ben-kuhn/Remote-LDGControl/cases/cable_clamp.stl

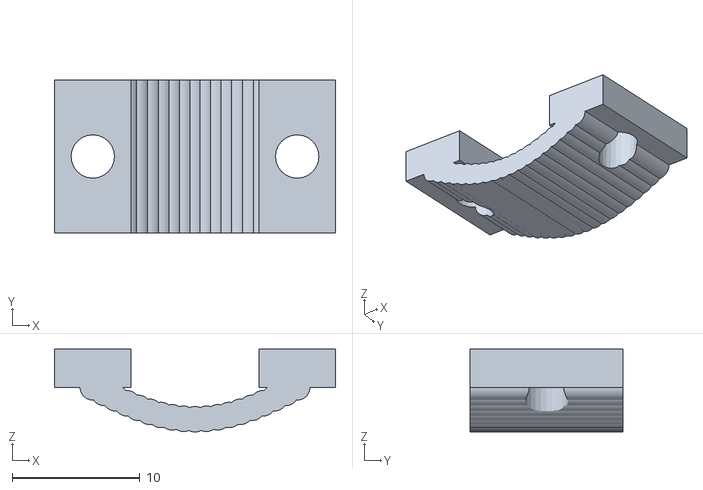
[picture p1: CAD file, 2026-11-12]
cases/cable_clamp.stl
22.0 x 12.0 x 6.50
