ben-kuhn/Remote-LDGControl/cases/remote_base.stl

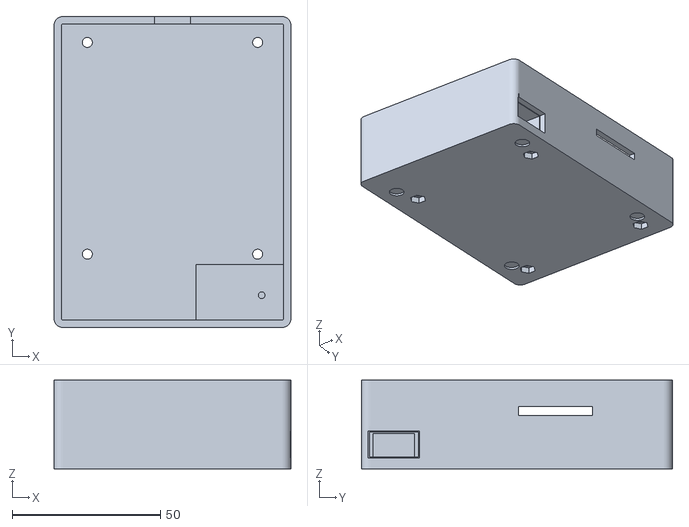
[picture p2: CAD file, 2026-11-12]
cases/remote_base.stl
80.0 x 105.0 x 30.0
