ben-kuhn/Remote-LDGControl/cases/remote_lid.stl

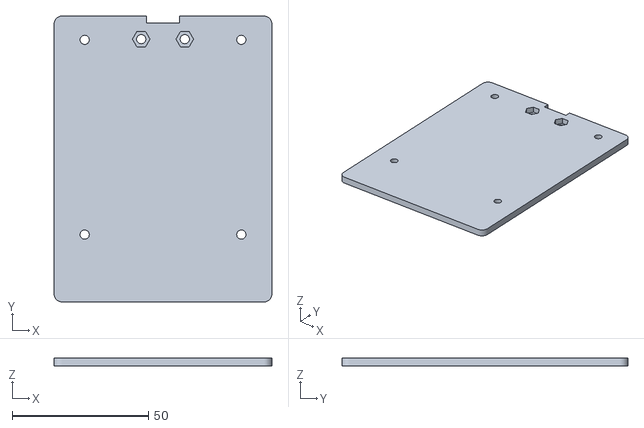
[picture p3: CAD file, 2026-11-12]
cases/remote_lid.stl
80.0 x 105.0 x 3.00
