ben-kuhn/Remote-LDGControl/src/web_server.cpp

#include "web_server.h"
#include "config_manager.h"
#include "portal_cert.h"
#include "config.h"
#include <ArduinoJson.h>
#include <LittleFS.h>
#include <WiFi.h>
#include <HTTPSServer.hpp>
#include <SSLCert.hpp>
#include <HTTPRequest.hpp>
#include <HTTPResponse.hpp>
#include <WebsocketHandler.hpp>
#include <WebsocketNode.hpp>
#include <freertos/FreeRTOS.h>
#include <vector>
#include <algorithm>

namespace hsv = httpsserver;

// ---------------------------------------------------------------------------
// Singleton + shared SSE state.
//
// The HTTPS library accepts plain function pointers for route handlers, so we
// can't capture `this` in lambdas. Handlers read from s_instance to reach
// LdgWebServer members, and from s_sse for the SSE push state. Each SSE
// subscriber runs its own connection task and polls s_sse seq counters.
// ---------------------------------------------------------------------------

static LdgWebServer* s_instance = nullptr;

struct SseState {
    portMUX_TYPE mux;
    uint32_t meterSeq;
    char meterJson[384];
    uint32_t statusSeq;
    char statusJson[96];
};
static SseState s_sse = {
    portMUX_INITIALIZER_UNLOCKED,
    0, "", 0, ""
};

// ---------------------------------------------------------------------------
// WebSocket meter subscribers.
//
// Unlike SSE, the library dispatches WS handlers non-inline — the slot stays
// in STATE_WEBSOCKET and the connection's loop() polls for client data, so a
// long-lived WS handler doesn't block the slot the way h_events does. That
// lets us keep one persistent connection per browser (no per-command TLS
// handshakes, no SSE session caps, no close-on-button-click dance) AND let
// command POSTs dispatch on free slots concurrently.
//
// Registry lives in the webServer task only — both registration (handler
// ctor) and broadcast (LdgWebServer::loop) execute there sequentially, so we
// don't need a mutex around the vector. The handler's dtor unregisters
// itself; the library calls delete on the handler from STATE_WEBSOCKET when
// the client closes (or the connection errors), and that happens between
// HTTPServer::loop() iterations, never concurrently with broadcastMeter().
// ---------------------------------------------------------------------------
class MeterWebsocketHandler : public hsv::WebsocketHandler {
public:
    MeterWebsocketHandler() { s_subs.push_back(this); }
    ~MeterWebsocketHandler() override {
        s_subs.erase(std::remove(s_subs.begin(), s_subs.end(), this), s_subs.end());
    }

    // Client → server messages are ignored for now; commands still use the
    // existing POST /api/command/* endpoints.
    void onMessage(hsv::WebsocketInputStreambuf* buf) override { (void)buf; }
    void onClose() override {}
    void onError(std::string err) override { (void)err; }

    // Factory for hsv::WebsocketNode.
    static hsv::WebsocketHandler* create() { return new MeterWebsocketHandler(); }

    // Push a meter JSON to every active subscriber. Single-threaded by design
    // — called from the webServer task only, never concurrent with
    // HTTPServer::loop()'s slot management.
    static void broadcastMeter(const char* json) {
        for (auto* h : s_subs) {
            if (!h->closed()) {
                h->send(std::string(json), SEND_TYPE_TEXT);
            }
        }
    }

private:
    static std::vector<MeterWebsocketHandler*> s_subs;
};

std::vector<MeterWebsocketHandler*> MeterWebsocketHandler::s_subs;

// Middleware: Basic-Auth-gate the WebSocket upgrade. The library's
// handleWebsocketHandshake doesn't authenticate, but middleware runs ahead
// of it in the chain — if we send 401 and skip next(), the handshake never
// happens and the slot closes cleanly. Browsers attach cached Basic Auth
// credentials to the WS upgrade request on the same origin, so this is
// transparent to the user once they've logged in via the regular page.
// Short-lived bearer tokens for the WebSocket upgrade.
//
// Browsers don't reliably send `Authorization: Basic ...` on WebSocket
// handshake requests (Chrome strips it, Firefox passes it, behavior varies
// by version). Basic Auth alone can't gate /api/ws. Pattern: the page (which
// IS Basic-Auth-gated) fetches a token from /api/ws-token, then opens the
// WS connection with ?t=<token> in the URL. Middleware validates the token
// out of the query string.
struct WsToken {
    char     value[33];    // 32 hex chars + null
    uint32_t expiresAtMs;  // millis() value; 0 = empty slot
};
static const int      WS_TOKEN_POOL_SIZE = 4;
static const uint32_t WS_TOKEN_TTL_MS    = 60 * 1000;  // 1 min, consumed on first connect
static WsToken s_wsTokens[WS_TOKEN_POOL_SIZE] = {};

static String issueWsToken() {
    uint8_t bin[16];
    esp_fill_random(bin, sizeof(bin));
    char hex[33];
    for (int i = 0; i < 16; i++) snprintf(&hex[i*2], 3, "%02x", bin[i]);
    hex[32] = '\0';

    // Reuse the slot with the soonest expiry (empty slots have expiresAtMs == 0
    // and therefore win the tiebreak).
    int slot = 0;
    for (int i = 1; i < WS_TOKEN_POOL_SIZE; i++) {
        if (s_wsTokens[i].expiresAtMs < s_wsTokens[slot].expiresAtMs) slot = i;
    }
    strncpy(s_wsTokens[slot].value, hex, sizeof(s_wsTokens[slot].value));
    s_wsTokens[slot].expiresAtMs = millis() + WS_TOKEN_TTL_MS;
    return String(hex);
}

// Consume the token — returns true if found and unexpired; clears the slot.
static bool consumeWsToken(const std::string& token) {
    uint32_t now = millis();
    for (int i = 0; i < WS_TOKEN_POOL_SIZE; i++) {
        if (s_wsTokens[i].expiresAtMs > now &&
            token == s_wsTokens[i].value) {
            s_wsTokens[i].expiresAtMs = 0;
            s_wsTokens[i].value[0] = '\0';
            return true;
        }
    }
    return false;
}

static void wsAuthMiddleware(hsv::HTTPRequest* req, hsv::HTTPResponse* res,
                             std::function<void()> next) {
    const std::string url = req->getRequestString();
    // URL is path[?query]. Prefix-match to find /api/ws with or without a
    // query string, but not e.g. /api/ws-token (different endpoint).
    if (url.compare(0, 7, "/api/ws") == 0 &&
        (url.length() == 7 || url[7] == '?')) {
        size_t qpos = url.find("?t=");
        std::string token = (qpos == std::string::npos) ? "" : url.substr(qpos + 3);
        size_t amp = token.find('&');
        if (amp != std::string::npos) token = token.substr(0, amp);
        Serial.printf("WS-MW: url='%s' token='%.8s...' len=%u\n",
                      url.c_str(), token.c_str(), (unsigned)token.length());
        if (token.empty() || !consumeWsToken(token)) {
            Serial.println("WS-MW: token reject → 401");
            res->setStatusCode(401);
            res->setHeader("Content-Type", "text/plain");
            res->print("WS token missing or invalid");
            return;  // don't call next() → no WS handshake
        }
        Serial.println("WS-MW: token ok → next()");
    }
    next();
}

// ---------------------------------------------------------------------------
// Helpers
// ---------------------------------------------------------------------------

static bool authenticate(hsv::HTTPRequest* req, hsv::HTTPResponse* res) {
    std::string user = req->getBasicAuthUser();
    std::string pass = req->getBasicAuthPassword();
    const DeviceConfig& cfg = configManager.get();
    if (!user.empty() && !pass.empty() &&
        user == cfg.webUsername && pass == cfg.webPassword) {
        return true;
    }
    res->setStatusCode(401);
    res->setHeader("WWW-Authenticate", "Basic realm=\"LDG Tuner\"");
    res->setHeader("Content-Type", "text/plain");
    res->print("Unauthorized");
    return false;
}

static std::string readRequestBody(hsv::HTTPRequest* req) {
    // readBytes() is non-blocking and returns 0 between SSL records, not only
    // at end-of-body. Drive the loop off requestComplete() so we don't bail
    // mid-body when the receive buffer is briefly empty.
    std::string body;
    uint8_t buf[256];
    uint32_t deadline = millis() + 5000;
    while (!req->requestComplete() && millis() < deadline) {
        size_t n = req->readBytes(buf, sizeof(buf));
        if (n > 0) {
            body.append((char*)buf, n);
            if (body.size() > 8192) break;  // sanity cap
        } else {
            delay(1);
        }
    }
    return body;
}

static void sendJson(hsv::HTTPResponse* res, int code, const String& body) {
    res->setStatusCode(code);
    res->setHeader("Content-Type", "application/json");
    res->print(body.c_str());
}

static const char* bandToString(tuner_band_t band) {
    return TunerProtocol::bandToString(band);
}

// Convert a meter to the JSON payload we ship over SSE / /api/status.
static String serializeMeter(const tuner_meter_t* meter, TunerProtocol* tuner) {
    JsonDocument doc;
    doc["fwd_power"] = meter->forward_power_watts;
    doc["ref_power"] = meter->reflected_power_watts;
    doc["swr"]       = meter->swr;
    doc["band"]      = bandToString(meter->band);
    if (tuner) {
        doc["mode"]    = tuner->getMode();
        doc["antenna"] = tuner->getAntenna();
    }
    String out;
    serializeJson(doc, out);
    return out;
}

// ---------------------------------------------------------------------------
// Handlers (all plain functions; access state through s_instance / globals)
// ---------------------------------------------------------------------------

static void h_root(hsv::HTTPRequest* req, hsv::HTTPResponse* res) {
    if (!authenticate(req, res)) return;
    res->setHeader("Content-Type", "text/html; charset=utf-8");

    if (LittleFS.exists("/index.html")) {
        File f = LittleFS.open("/index.html", "r");
        if (f) {
            uint8_t buf[512];
            int n;
            while ((n = f.read(buf, sizeof(buf))) > 0) {
                res->write(buf, n);
            }
            f.close();
            return;
        }
    }

    res->print(
        "<!DOCTYPE html><html><head>"
        "<meta name='viewport' content='width=device-width,initial-scale=1'>"
        "<title>LDG Tuner</title>"
        "</head><body><h1>LDG Tuner</h1>"
        "<p>The web UI file (/index.html) is missing from LittleFS. "
        "Re-upload the data partition.</p>"
        "</body></html>"
    );
}

static void h_status(hsv::HTTPRequest* req, hsv::HTTPResponse* res) {
    if (!authenticate(req, res)) return;

    LdgWebServer* self = s_instance;
    if (!self) { sendJson(res, 500, "{\"error\":\"no instance\"}"); return; }

    const tuner_meter_t* meter = nullptr;
    if (self->getMeterGetter()) meter = self->getMeterGetter()();
    else if (self->getTuner())  meter = self->getTuner()->getMeterData();

    if (!meter) { sendJson(res, 500, "{\"error\":\"no meter data\"}"); return; }

    JsonDocument doc;
    doc["fwd_power"] = meter->forward_power_watts;
    doc["ref_power"] = meter->reflected_power_watts;
    doc["swr"]       = meter->swr;
    doc["band"]      = bandToString(meter->band);
    if (self->getTuner()) {
        doc["mode"]      = self->getTuner()->getMode();
        doc["antenna"]   = self->getTuner()->getAntenna();
        doc["connected"] = self->getTuner()->isConnected();
    }
    String out;
    serializeJson(doc, out);
    sendJson(res, 200, out);
}

static void h_config_get(hsv::HTTPRequest* req, hsv::HTTPResponse* res) {
    if (!authenticate(req, res)) return;

    const DeviceConfig& cfg = configManager.get();
    JsonDocument doc;
    doc["mqttBroker"]      = cfg.mqttBroker;
    doc["mqttPort"]        = cfg.mqttPort;
    doc["mqttUsername"]    = cfg.mqttUsername;
    doc["webUsername"]     = cfg.webUsername;
    doc["meterPsuVoltage"] = cfg.meterPsuVoltage;
    doc["ant1Name"]        = cfg.ant1Name;
    doc["ant2Name"]        = cfg.ant2Name;
    doc["configured"]      = cfg.configured;
    doc["useStaticIP"]     = cfg.useStaticIP;
    doc["staticIP"]        = cfg.staticIP;
    doc["staticNetmask"]   = cfg.staticNetmask;
    doc["staticGateway"]   = cfg.staticGateway;
    doc["staticDNS"]       = cfg.staticDNS;
    doc["currentIP"]       = WiFi.localIP().toString();
    doc["currentNetmask"]  = WiFi.subnetMask().toString();
    doc["currentGateway"]  = WiFi.gatewayIP().toString();
    doc["currentDNS"]      = WiFi.dnsIP().toString();
    doc["wifiSSID"]        = WiFi.SSID();
#ifdef WITH_DISPLAY
    doc["remoteHost"]      = cfg.remoteHost;
    doc["build"]           = "display";
#else
    doc["build"]           = "remote";
#endif
    String out;
    serializeJson(doc, out);
    sendJson(res, 200, out);
}

static void h_config_post(hsv::HTTPRequest* req, hsv::HTTPResponse* res) {
    if (!authenticate(req, res)) return;

    std::string body = readRequestBody(req);
    JsonDocument doc;
    DeserializationError err = deserializeJson(doc, body);
    if (err) { sendJson(res, 400, "{\"error\":\"invalid json\"}"); return; }

    if (doc["reset"].is<bool>() && doc["reset"].as<bool>()) {
        configManager.reset();
        sendJson(res, 200, "{\"result\":\"ok\",\"restart\":true}");
        delay(500);
        ESP.restart();
        return;
    }

    DeviceConfig cfg = configManager.get();
    if (doc["mqttBroker"])      strncpy(cfg.mqttBroker,   doc["mqttBroker"],   sizeof(cfg.mqttBroker)   - 1);
    if (doc["mqttPort"])        cfg.mqttPort = doc["mqttPort"];
    if (doc["mqttUsername"])    strncpy(cfg.mqttUsername, doc["mqttUsername"], sizeof(cfg.mqttUsername) - 1);
    if (doc["mqttPassword"])    strncpy(cfg.mqttPassword, doc["mqttPassword"], sizeof(cfg.mqttPassword) - 1);
    if (doc["webUsername"])     strncpy(cfg.webUsername,  doc["webUsername"],  sizeof(cfg.webUsername)  - 1);
    if (doc["webPassword"])     strncpy(cfg.webPassword,  doc["webPassword"],  sizeof(cfg.webPassword)  - 1);
    if (doc["meterPsuVoltage"]) cfg.meterPsuVoltage = doc["meterPsuVoltage"];
    if (doc["ant1Name"])        strncpy(cfg.ant1Name, doc["ant1Name"], sizeof(cfg.ant1Name) - 1);
    if (doc["ant2Name"])        strncpy(cfg.ant2Name, doc["ant2Name"], sizeof(cfg.ant2Name) - 1);
    if (doc["useStaticIP"].is<bool>())  cfg.useStaticIP = doc["useStaticIP"];
    if (doc["staticIP"].is<const char*>())      strncpy(cfg.staticIP,      doc["staticIP"],      sizeof(cfg.staticIP)      - 1);
    if (doc["staticNetmask"].is<const char*>()) strncpy(cfg.staticNetmask, doc["staticNetmask"], sizeof(cfg.staticNetmask) - 1);
    if (doc["staticGateway"].is<const char*>()) strncpy(cfg.staticGateway, doc["staticGateway"], sizeof(cfg.staticGateway) - 1);
    if (doc["staticDNS"].is<const char*>())     strncpy(cfg.staticDNS,     doc["staticDNS"],     sizeof(cfg.staticDNS)     - 1);
#ifdef WITH_DISPLAY
    if (doc["remoteHost"].is<const char*>())    strncpy(cfg.remoteHost, doc["remoteHost"], sizeof(cfg.remoteHost) - 1);
#endif
    cfg.configured = true;

    if (configManager.update(cfg)) {
        sendJson(res, 200, "{\"result\":\"ok\",\"restart\":true}");
        delay(500);
        ESP.restart();
    } else {
        sendJson(res, 500, "{\"error\":\"save failed\"}");
    }
}

// Each command endpoint as a separate handler — the library's route registration
// takes a function pointer, so we can't bind the cmd parameter.
static void runCommand(hsv::HTTPResponse* res, uint8_t cmd) {
    LdgWebServer* self = s_instance;
    if (!self) { sendJson(res, 500, "{\"error\":\"no instance\"}"); return; }

    bool ok = false;
    if (self->getCmdHandler()) {
        ok = self->getCmdHandler()(cmd);
    } else if (self->getTuner()) {
        switch (cmd) {
            case TUNER_CMD_TOGGLE_ANT:  ok = self->getTuner()->toggleAntenna();   break;
            case TUNER_CMD_MEM_TUNE:    ok = self->getTuner()->memoryTune();      break;
            case TUNER_CMD_FULL_TUNE:   ok = self->getTuner()->fullTune();        break;
            case TUNER_CMD_BYPASS:      ok = self->getTuner()->bypass();          break;
            case TUNER_CMD_AUTO_MODE:   ok = self->getTuner()->setAutoMode();     break;
            case TUNER_CMD_MANUAL_MODE: ok = self->getTuner()->setManualMode();   break;
        }
    }
    JsonDocument doc;
    doc["command"] = cmd;
    doc["result"]  = ok ? "success" : "failed";
    String out;
    serializeJson(doc, out);
    sendJson(res, 200, out);
}

// Issue a single-use WS upgrade token for the current authenticated user.
static void h_ws_token(hsv::HTTPRequest* req, hsv::HTTPResponse* res) {
    if (!authenticate(req, res)) return;
    String body = "{\"token\":\"" + issueWsToken() + "\"}";
    sendJson(res, 200, body);
}

static void h_cmd_toggle      (hsv::HTTPRequest* req, hsv::HTTPResponse* res) { if (!authenticate(req, res)) return; runCommand(res, TUNER_CMD_TOGGLE_ANT); }
static void h_cmd_memory_tune (hsv::HTTPRequest* req, hsv::HTTPResponse* res) { if (!authenticate(req, res)) return; runCommand(res, TUNER_CMD_MEM_TUNE); }
static void h_cmd_full_tune   (hsv::HTTPRequest* req, hsv::HTTPResponse* res) { if (!authenticate(req, res)) return; runCommand(res, TUNER_CMD_FULL_TUNE); }
static void h_cmd_bypass      (hsv::HTTPRequest* req, hsv::HTTPResponse* res) { if (!authenticate(req, res)) return; runCommand(res, TUNER_CMD_BYPASS); }
static void h_cmd_auto        (hsv::HTTPRequest* req, hsv::HTTPResponse* res) { if (!authenticate(req, res)) return; runCommand(res, TUNER_CMD_AUTO_MODE); }
static void h_cmd_manual      (hsv::HTTPRequest* req, hsv::HTTPResponse* res) { if (!authenticate(req, res)) return; runCommand(res, TUNER_CMD_MANUAL_MODE); }

static void h_telemetry(hsv::HTTPRequest* req, hsv::HTTPResponse* res) {
    if (!authenticate(req, res)) return;

    std::string body = readRequestBody(req);
    JsonDocument doc;
    DeserializationError err = deserializeJson(doc, body);
    if (err) { sendJson(res, 400, "{\"error\":\"invalid json\"}"); return; }

    tuner_meter_t meter{};
    meter.forward_power_watts   = doc["fwd_power"] | 0.0;
    meter.reflected_power_watts = doc["ref_power"] | 0.0;
    meter.swr                   = doc["swr"]       | 1.0;
    meter.forward_power_raw     = doc["fwd_raw"]   | 0;
    meter.reflected_power_raw   = doc["ref_raw"]   | 0;

    const char* b = doc["band"];
    if (b) {
        if      (!strcmp(b, "160m")) meter.band = BAND_160M;
        else if (!strcmp(b, "80m"))  meter.band = BAND_80M;
        else if (!strcmp(b, "60m"))  meter.band = BAND_60M;
        else if (!strcmp(b, "40m"))  meter.band = BAND_40M;
        else if (!strcmp(b, "30m"))  meter.band = BAND_30M;
        else if (!strcmp(b, "20m"))  meter.band = BAND_20M;
        else if (!strcmp(b, "17m"))  meter.band = BAND_17M;
        else if (!strcmp(b, "15m"))  meter.band = BAND_15M;
        else if (!strcmp(b, "12m"))  meter.band = BAND_12M;
        else if (!strcmp(b, "10m"))  meter.band = BAND_10M;
        else if (!strcmp(b, "6m"))   meter.band = BAND_6M;
        else                         meter.band = BAND_UNKNOWN;
    }

    if (s_instance) {
        s_instance->pushMeterEvent(&meter);
        if (s_instance->getRemoteTelemetryHandler()) {
            s_instance->getRemoteTelemetryHandler()(&meter);
        }
    }
    sendJson(res, 200, "{\"result\":\"ok\"}");
}


// ---------------------------------------------------------------------------
// LdgWebServer methods
// ---------------------------------------------------------------------------

LdgWebServer::LdgWebServer()
    : m_server(nullptr), m_sslCert(nullptr), m_tuner(nullptr),
      m_cmdHandler(nullptr), m_meterGetter(nullptr),
      m_remoteTelemetryHandler(nullptr), m_lastMeterUpdate(0) {
    s_instance = this;
}

LdgWebServer::~LdgWebServer() {
    if (m_server) { m_server->stop(); delete m_server; }
    if (m_sslCert) delete m_sslCert;
    if (s_instance == this) s_instance = nullptr;
}

bool LdgWebServer::begin(TunerProtocol* tuner, command_handler_t cmdHandler,
                         meter_getter_t meterGetter,
                         remote_telemetry_handler_t remoteTelemetryHandler) {
    m_tuner = tuner;
    m_cmdHandler = cmdHandler;
    m_meterGetter = meterGetter;
    m_remoteTelemetryHandler = remoteTelemetryHandler;
    s_instance = this;

    m_sslCert = portalCert_newSSLCert();
    if (!m_sslCert) {
        Serial.println("ERROR: runtime web server: no SSL cert");
        return false;
    }

    // The captive portal HTTPSServer is torn down in setupWiFi() after STA
    // join (with a 3s wait so its last connection drains), so port 443 is
    // free here. Bind to 0.0.0.0 so the runtime is reachable on every
    // interface — including the softAP on display units where the remote
    // unit needs to talk to it.
    m_server = new hsv::HTTPSServer(m_sslCert, 443, 4);

    m_server->registerNode(new hsv::ResourceNode("/",                   "GET",  &h_root));
    m_server->registerNode(new hsv::ResourceNode("/api/status",         "GET",  &h_status));
    m_server->registerNode(new hsv::ResourceNode("/api/config",         "GET",  &h_config_get));
    m_server->registerNode(new hsv::ResourceNode("/api/config",         "POST", &h_config_post));
    m_server->registerNode(new hsv::ResourceNode("/api/telemetry",      "POST", &h_telemetry));
    m_server->registerNode(new hsv::ResourceNode("/api/command/toggle",      "POST", &h_cmd_toggle));
    m_server->registerNode(new hsv::ResourceNode("/api/command/memory_tune", "POST", &h_cmd_memory_tune));
    m_server->registerNode(new hsv::ResourceNode("/api/command/full_tune",   "POST", &h_cmd_full_tune));
    m_server->registerNode(new hsv::ResourceNode("/api/command/bypass",      "POST", &h_cmd_bypass));
    m_server->registerNode(new hsv::ResourceNode("/api/command/auto",        "POST", &h_cmd_auto));
    m_server->registerNode(new hsv::ResourceNode("/api/command/manual",      "POST", &h_cmd_manual));

    // WebSocket telemetry channel — persistent, non-blocking, replaces SSE
    // for the live meter feed. The library dispatches WS handlers non-inline,
    // so a connected browser does not block command POSTs the way SSE did.
    // /api/ws-token issues a single-use bearer token (Basic Auth required);
    // the page fetches one and opens the WS at /api/ws?t=<token>. Browsers
    // don't reliably send Basic Auth on WS upgrades, hence the token dance.
    m_server->registerNode(new hsv::ResourceNode("/api/ws-token",            "GET",  &h_ws_token));
    m_server->addMiddleware(&wsAuthMiddleware);
    m_server->registerNode(new hsv::WebsocketNode("/api/ws", &MeterWebsocketHandler::create));

    m_server->start();
    if (!m_server->isRunning()) {
        Serial.println("ERROR: runtime HTTPS server failed to bind :443");
        return false;
    }
    Serial.println("Runtime HTTPS server started on :443");
    return true;
}

void LdgWebServer::loop() {
    if (m_server) m_server->loop();

    // Mirror the meter into SSE state every 500ms so polling subscribers see
    // updates without us needing an explicit push from every meter source.
    if (millis() - m_lastMeterUpdate > 500) {
        const tuner_meter_t* meter = nullptr;
        if (m_meterGetter)   meter = m_meterGetter();
        else if (m_tuner)    meter = m_tuner->getMeterData();
        if (meter) pushMeterEvent(meter);
        m_lastMeterUpdate = millis();
    }

    // Broadcast newly-published meter data to every connected WebSocket
    // subscriber. seq-based gating means we only send when something actually
    // changed since the last broadcast. This runs in the webServer task right
    // after HTTPServer::loop(), so it cannot race with the library's
    // creation/deletion of MeterWebsocketHandler instances.
    uint32_t currSeq;
    char buf[sizeof(s_sse.meterJson)];
    portENTER_CRITICAL(&s_sse.mux);
    currSeq = s_sse.meterSeq;
    if (currSeq != m_lastWsMeterSeq) {
        strncpy(buf, s_sse.meterJson, sizeof(buf));
        buf[sizeof(buf) - 1] = '\0';
    }
    portEXIT_CRITICAL(&s_sse.mux);
    if (currSeq != m_lastWsMeterSeq) {
        MeterWebsocketHandler::broadcastMeter(buf);
        m_lastWsMeterSeq = currSeq;
    }
}

void LdgWebServer::pushMeterEvent(const tuner_meter_t* meter) {
    String payload = serializeMeter(meter, m_tuner);
    portENTER_CRITICAL(&s_sse.mux);
    strncpy(s_sse.meterJson, payload.c_str(), sizeof(s_sse.meterJson));
    s_sse.meterJson[sizeof(s_sse.meterJson) - 1] = '\0';
    s_sse.meterSeq++;
    portEXIT_CRITICAL(&s_sse.mux);
}

void LdgWebServer::pushStatusEvent(const char* status) {
    if (!status) return;
    portENTER_CRITICAL(&s_sse.mux);
    strncpy(s_sse.statusJson, status, sizeof(s_sse.statusJson));
    s_sse.statusJson[sizeof(s_sse.statusJson) - 1] = '\0';
    s_sse.statusSeq++;
    portEXIT_CRITICAL(&s_sse.mux);
}
