ben-kuhn/Remote-LDGControl/src/display_ui.cpp

#ifdef WITH_DISPLAY

#include "display_ui.h"
#include "config_manager.h"
#include <WiFi.h>
#include <Wire.h>
#include <math.h>

// NS2009 I2C touch controller (BTT TFT35-SPI V2.1)
// I2C address: 0x48
#define NS2009_ADDR 0x48
#define NS2009_CMD_READ_X 0xC0
#define NS2009_CMD_READ_Y 0xD0

DisplayUI* DisplayUI::s_instance = nullptr;

static bool ns2009Read(uint16_t* x, uint16_t* y) {
    Wire.requestFrom(NS2009_ADDR, (uint8_t)5);
    if (Wire.available() < 5) return false;
    Wire.read(); // skip status
    uint8_t xh = Wire.read();
    uint8_t xl = Wire.read();
    uint8_t yh = Wire.read();
    uint8_t yl = Wire.read();
    *x = (xh << 5) | (xl >> 3);
    *y = (yh << 5) | (yl >> 3);
    return true;
}

static bool tsTouched() {
    Wire.beginTransmission(NS2009_ADDR);
    Wire.write(NS2009_CMD_READ_X);
    return (Wire.endTransmission() == 0);
}

DisplayUI::DisplayUI()
    : m_tft(nullptr), m_tuner(nullptr),
      m_scr(nullptr), m_meter(nullptr),
      m_bandLabel(nullptr), m_scaleLabel(nullptr),
      m_modeLabel(nullptr),
      m_ssidLabel(nullptr), m_ipLabel(nullptr),
      m_btnMemTune(nullptr), m_btnFullTune(nullptr),
      m_btnAnt1(nullptr), m_btnAnt2(nullptr),
      m_ant1NameLabel(nullptr), m_ant2NameLabel(nullptr),
      m_btnBypass(nullptr), m_btnAuto(nullptr),
      m_highScale(true), m_maxPower(1000.0f),
      m_fwdPower(0), m_refPower(0), m_swr(1.0f),
      m_activeAnt(ANT_UNKNOWN) {
    s_instance = this;
}

DisplayUI::~DisplayUI() {
    if (m_tft) delete m_tft;
    s_instance = nullptr;
}

bool DisplayUI::begin(TunerProtocol* tuner) {
    m_tuner = tuner;
    m_tft = new TFT_eSPI();
    m_tft->init();
    m_tft->setRotation(DISPLAY_ROTATION);
    m_tft->fillScreen(TFT_BLACK);

    lv_init();
    Wire.begin(TOUCH_SDA, TOUCH_SCL);

    static lv_disp_draw_buf_t draw_buf;
    // 5-line draw buffers (~4.8 KB each). LVGL recommends ~1/10 of the
    // screen height as the minimum; halving from 10 lines keeps perf
    // reasonable while saving ~9.6 KB of dram0.bss — the difference
    // between the display variant linking or not.
    static lv_color_t buf1[DISPLAY_WIDTH * 5];
    static lv_color_t buf2[DISPLAY_WIDTH * 5];
    lv_disp_draw_buf_init(&draw_buf, buf1, buf2, DISPLAY_WIDTH * 5);

    static lv_disp_drv_t disp_drv;
    lv_disp_drv_init(&disp_drv);
    disp_drv.hor_res = DISPLAY_WIDTH;
    disp_drv.ver_res = DISPLAY_HEIGHT;
    disp_drv.flush_cb = displayFlush;
    disp_drv.draw_buf = &draw_buf;
    lv_disp_drv_register(&disp_drv);

    setupTouch();

    m_scr = lv_obj_create(NULL);
    lv_obj_set_style_bg_color(m_scr, lv_color_hex(0x0a0a1a), LV_PART_MAIN);
    lv_obj_set_style_border_width(m_scr, 0, LV_PART_MAIN);
    lv_scr_load(m_scr);

    // ============================================================
    // LEFT PANEL: Cross-needle meter (~300x300)
    // ============================================================
    m_meter = lv_obj_create(m_scr);
    lv_obj_set_size(m_meter, 300, 300);
    lv_obj_align(m_meter, LV_ALIGN_LEFT_MID, 0, 0);
    lv_obj_set_style_bg_color(m_meter, lv_color_hex(0x111122), LV_PART_MAIN);
    lv_obj_set_style_border_width(m_meter, 0, LV_PART_MAIN);
    lv_obj_set_style_radius(m_meter, 0, LV_PART_MAIN);
    lv_obj_add_flag(m_meter, LV_OBJ_FLAG_CLICKABLE);
    lv_obj_add_event_cb(m_meter, drawMeterEvent, LV_EVENT_DRAW_POST, NULL);
    lv_obj_add_event_cb(m_meter, meterTapEvent, LV_EVENT_CLICKED, NULL);

    // Band label
    m_bandLabel = lv_label_create(m_scr);
    lv_label_set_text(m_bandLabel, "Band: --");
    lv_obj_set_style_text_color(m_bandLabel, lv_color_hex(0x00ff00), LV_PART_MAIN);
    lv_obj_set_style_text_font(m_bandLabel, &lv_font_montserrat_16, LV_PART_MAIN);
    lv_obj_align_to(m_bandLabel, m_meter, LV_ALIGN_OUT_BOTTOM_LEFT, 10, 5);

    // Scale label
    m_scaleLabel = lv_label_create(m_scr);
    lv_label_set_text(m_scaleLabel, "1000W");
    lv_obj_set_style_text_color(m_scaleLabel, lv_color_hex(0x888888), LV_PART_MAIN);
    lv_obj_set_style_text_font(m_scaleLabel, &lv_font_montserrat_16, LV_PART_MAIN);
    lv_obj_align_to(m_scaleLabel, m_meter, LV_ALIGN_OUT_BOTTOM_RIGHT, -10, 5);

    // ============================================================
    // RIGHT PANEL: Info + buttons (~150px wide)
    // ============================================================
    int rightX = 310;

    // SSID
    m_ssidLabel = lv_label_create(m_scr);
    lv_label_set_text_fmt(m_ssidLabel, "SSID: %s", WiFi.SSID().c_str());
    lv_obj_set_style_text_color(m_ssidLabel, lv_color_hex(0x666666), LV_PART_MAIN);
    lv_obj_set_style_text_font(m_ssidLabel, &lv_font_montserrat_14, LV_PART_MAIN);
    lv_obj_align(m_ssidLabel, LV_ALIGN_TOP_RIGHT, -5, 5);

    // IP
    m_ipLabel = lv_label_create(m_scr);
    lv_label_set_text_fmt(m_ipLabel, "IP: %s", WiFi.localIP().toString().c_str());
    lv_obj_set_style_text_color(m_ipLabel, lv_color_hex(0x666666), LV_PART_MAIN);
    lv_obj_set_style_text_font(m_ipLabel, &lv_font_montserrat_14, LV_PART_MAIN);
    lv_obj_align(m_ipLabel, LV_ALIGN_TOP_RIGHT, -5, 22);

    // Mode
    m_modeLabel = lv_label_create(m_scr);
    lv_label_set_text(m_modeLabel, "Mode: --");
    lv_obj_set_style_text_color(m_modeLabel, lv_color_hex(0xffffff), LV_PART_MAIN);
    lv_obj_set_style_text_font(m_modeLabel, &lv_font_montserrat_14, LV_PART_MAIN);
    lv_obj_align(m_modeLabel, LV_ALIGN_TOP_RIGHT, -5, 45);

    // Buttons — full-width single-line buttons for tuning commands
    int btnX = rightX + 5;
    int btnW = 140;
    int btnH = 36;
    int btnGap = 5;

    auto makeBtn = [&](lv_obj_t** out, const char* label, int x, int y, int w, int h,
                       lv_color_t bg, lv_color_t pressed) {
        *out = lv_btn_create(m_scr);
        lv_obj_set_size(*out, w, h);
        lv_obj_set_pos(*out, x, y);
        lv_obj_set_style_bg_color(*out, bg, LV_PART_MAIN);
        lv_obj_set_style_bg_color(*out, pressed, LV_PART_MAIN | LV_STATE_PRESSED);
        lv_obj_set_style_radius(*out, 4, LV_PART_MAIN);
        lv_obj_t* lbl = lv_label_create(*out);
        lv_label_set_text(lbl, label);
        lv_obj_center(lbl);
    };

    // Buttons start just below the Mode label (y=45 + ~18px font height + 4px gap)
    const int btnY0 = 67;

    makeBtn(&m_btnMemTune,  "MEM TUNE",  btnX, btnY0,              btnW, btnH,
            lv_color_hex(0xcc3333), lv_color_hex(0xff4444));
    makeBtn(&m_btnFullTune, "FULL TUNE", btnX, btnY0 + btnH + btnGap, btnW, btnH,
            lv_color_hex(0xcc3333), lv_color_hex(0xff4444));

    // ANT buttons — side-by-side, nearly square, two-line (identifier + configurable name)
    // Width = (btnW - gap) / 2 = 67 each; height = 67 for near-square
    const int antW = (btnW - btnGap) / 2;   // 67
    const int antH = antW;                   // 67 — square
    const int antY = btnY0 + 2 * (btnH + btnGap);
    const DeviceConfig& cfg = configManager.get();

    auto makeAntBtn = [&](lv_obj_t** btn, lv_obj_t** nameLabel,
                          const char* idText, const char* name, int x) {
        *btn = lv_btn_create(m_scr);
        lv_obj_set_size(*btn, antW, antH);
        lv_obj_set_pos(*btn, x, antY);
        lv_obj_set_style_bg_color(*btn, lv_color_hex(0x2a2a3a), LV_PART_MAIN);
        lv_obj_set_style_radius(*btn, 4, LV_PART_MAIN);
        lv_obj_set_style_pad_all(*btn, 2, LV_PART_MAIN);

        lv_obj_t* id = lv_label_create(*btn);
        lv_label_set_text(id, idText);
        lv_obj_set_style_text_font(id, &lv_font_montserrat_14, LV_PART_MAIN);
        lv_obj_align(id, LV_ALIGN_TOP_MID, 0, 4);

        *nameLabel = lv_label_create(*btn);
        lv_label_set_text(*nameLabel, name);
        lv_obj_set_style_text_font(*nameLabel, &lv_font_montserrat_10, LV_PART_MAIN);
        lv_obj_set_style_text_color(*nameLabel, lv_color_hex(0xaaaaaa), LV_PART_MAIN);
        lv_label_set_long_mode(*nameLabel, LV_LABEL_LONG_CLIP);
        lv_obj_set_width(*nameLabel, antW - 4);
        lv_obj_set_style_text_align(*nameLabel, LV_TEXT_ALIGN_CENTER, LV_PART_MAIN);
        lv_obj_align(*nameLabel, LV_ALIGN_BOTTOM_MID, 0, -4);
    };

    makeAntBtn(&m_btnAnt1, &m_ant1NameLabel, "ANT 1", cfg.ant1Name, btnX);
    makeAntBtn(&m_btnAnt2, &m_ant2NameLabel, "ANT 2", cfg.ant2Name, btnX + antW + btnGap);

    makeBtn(&m_btnBypass, "BYPASS",    btnX, antY + antH + btnGap, btnW, btnH,
            lv_color_hex(0xcc8800), lv_color_hex(0xffaa00));
    makeBtn(&m_btnAuto,   "AUTO MODE", btnX, antY + antH + btnGap + btnH + btnGap, btnW, btnH,
            lv_color_hex(0x2255aa), lv_color_hex(0x3366cc));

    lv_obj_add_event_cb(m_btnMemTune,  btnMemTuneEvent,  LV_EVENT_CLICKED, NULL);
    lv_obj_add_event_cb(m_btnFullTune, btnFullTuneEvent, LV_EVENT_CLICKED, NULL);
    lv_obj_add_event_cb(m_btnAnt1,     btnAnt1Event,     LV_EVENT_CLICKED, NULL);
    lv_obj_add_event_cb(m_btnAnt2,     btnAnt2Event,     LV_EVENT_CLICKED, NULL);
    lv_obj_add_event_cb(m_btnBypass,   btnBypassEvent,   LV_EVENT_CLICKED, NULL);
    lv_obj_add_event_cb(m_btnAuto,     btnAutoEvent,     LV_EVENT_CLICKED, NULL);

    return true;
}

void DisplayUI::loop() {
    lv_timer_handler();
    delay(5);
}

void DisplayUI::updateMeter(const tuner_meter_t* meter) {
    m_fwdPower = (float)meter->forward_power_watts;
    m_refPower = (float)meter->reflected_power_watts;
    m_swr = (float)meter->swr;

    lv_obj_invalidate(m_meter);

    char buf[32];
    snprintf(buf, sizeof(buf), "Band: %s", TunerProtocol::bandToString(meter->band));
    lv_label_set_text(m_bandLabel, buf);
}

void DisplayUI::updateNetworkInfo() {
    if (m_ssidLabel)
        lv_label_set_text_fmt(m_ssidLabel, "SSID: %s", WiFi.SSID().c_str());
    if (m_ipLabel)
        lv_label_set_text_fmt(m_ipLabel, "IP: %s", WiFi.localIP().toString().c_str());
}

void DisplayUI::updateStatus(tuner_mode_t mode, tuner_ant_t antenna) {
    switch (mode) {
        case MODE_AUTO:    lv_label_set_text(m_modeLabel, "Mode: AUTO"); break;
        case MODE_MANUAL:  lv_label_set_text(m_modeLabel, "Mode: MANUAL"); break;
        case MODE_BYPASS:  lv_label_set_text(m_modeLabel, "Mode: BYPASS"); break;
        default:           lv_label_set_text(m_modeLabel, "Mode: --"); break;
    }
    m_activeAnt = antenna;
    updateAntButtons();
}

void DisplayUI::updateAntButtons() {
    const DeviceConfig& cfg = configManager.get();
    lv_label_set_text(m_ant1NameLabel, cfg.ant1Name);
    lv_label_set_text(m_ant2NameLabel, cfg.ant2Name);

    lv_color_t activeColor   = lv_color_hex(0x2255aa);
    lv_color_t inactiveColor = lv_color_hex(0x2a2a3a);
    lv_obj_set_style_bg_color(m_btnAnt1,
        m_activeAnt == ANT_A ? activeColor : inactiveColor, LV_PART_MAIN);
    lv_obj_set_style_bg_color(m_btnAnt2,
        m_activeAnt == ANT_B ? activeColor : inactiveColor, LV_PART_MAIN);
}

void DisplayUI::setupTouch() {
    static lv_indev_drv_t indev_drv;
    lv_indev_drv_init(&indev_drv);
    indev_drv.type = LV_INDEV_TYPE_POINTER;
    indev_drv.read_cb = [](lv_indev_drv_t* drv, lv_indev_data_t* data) {
        if (s_instance) s_instance->readTouch(drv, data);
    };
    lv_indev_drv_register(&indev_drv);
}

void DisplayUI::readTouch(lv_indev_drv_t* drv, lv_indev_data_t* data) {
    if (tsTouched()) {
        uint16_t x, y;
        if (ns2009Read(&x, &y)) {
            data->state = LV_INDEV_STATE_PR;
            data->point.x = map(x, 200, 3900, 0, DISPLAY_WIDTH);
            data->point.y = map(y, 200, 3900, 0, DISPLAY_HEIGHT);
        } else {
            data->state = LV_INDEV_STATE_REL;
        }
    } else {
        data->state = LV_INDEV_STATE_REL;
    }
}

void DisplayUI::drawMeterEvent(lv_event_t* e) {
    if (s_instance) s_instance->drawCrossNeedle(e);
}

void DisplayUI::drawCrossNeedle(lv_event_t* e) {
    lv_draw_ctx_t* draw_ctx = lv_event_get_draw_ctx(e);
    lv_obj_t* obj = lv_event_get_target(e);
    int w = lv_obj_get_width(obj);
    int h = lv_obj_get_height(obj);

    const int pad      = 20;
    const int cx       = w / 2;
    const int cy       = h - pad;          // pivot row, bottom of meter area
    const int halfBase = w / 2 - pad;      // horizontal distance from centre to each pivot
    const int arm      = cy - pad;         // needle length = arc radius; arm > halfBase → arcs cross
    const float PI_F   = 3.14159265f;

    // Pivot positions: forward bottom-right, reflected bottom-left.
    // With arm == 2*halfBase (true when meter is square) each arc passes exactly
    // through the other pivot, giving a natural zero-power resting position.
    const int fwdPx = cx + halfBase;
    const int fwdPy = cy;
    const int refPx = cx - halfBase;
    const int refPy = cy;

    // Needle angles (math convention: tip_x = pivot_x + arm*cos θ,
    //                                 tip_y = pivot_y − arm*sin θ)
    // Forward: θ = PI  (pointing left)  at 0 W  →  θ = PI/2 (pointing up) at max W
    // Reflected: θ = 0 (pointing right) at 0 W  →  θ = PI/2 (pointing up) at max W
    const float fwdFrac  = fminf(m_fwdPower / m_maxPower, 1.0f);
    const float refFrac  = fminf(m_refPower  / m_maxPower, 1.0f);
    const float fwdTheta = PI_F - fwdFrac * (PI_F / 2.0f);
    const float refTheta = refFrac * (PI_F / 2.0f);
    const int fwdTx = fwdPx + (int)(arm * cosf(fwdTheta));
    const int fwdTy = fwdPy - (int)(arm * sinf(fwdTheta));
    const int refTx = refPx + (int)(arm * cosf(refTheta));
    const int refTy = refPy - (int)(arm * sinf(refTheta));

    // ----- Scale arcs (one per pivot, each spanning the full 90° sweep) -----
    // Forward arc: upper-left quarter around fwd pivot (LVGL 180° → 270°, clockwise = left→up)
    // Reflected arc: upper-right quarter around ref pivot (LVGL 270° → 360°, clockwise = up→right)
    lv_draw_arc_dsc_t arc_dsc;
    lv_draw_arc_dsc_init(&arc_dsc);
    arc_dsc.width = 2;
    arc_dsc.color = lv_color_hex(0x22c55e);
    lv_point_t fwd_ctr = {(lv_coord_t)fwdPx, (lv_coord_t)fwdPy};
    lv_draw_arc(draw_ctx, &arc_dsc, &fwd_ctr, arm, 180, 270);
    arc_dsc.color = lv_color_hex(0xef4444);
    lv_point_t ref_ctr = {(lv_coord_t)refPx, (lv_coord_t)refPy};
    lv_draw_arc(draw_ctx, &arc_dsc, &ref_ctr, arm, 270, 360);

    // ----- Tick marks + labels along each arc -----
    // thetaZero = needle angle at 0 W, thetaFull = angle at max W
    auto drawTicks = [&](int px, int py, float thetaZero, float thetaFull, uint32_t color) {
        const int N = 8;
        for (int i = 0; i <= N; i++) {
            const float f     = (float)i / (float)N;
            const float theta = thetaZero + f * (thetaFull - thetaZero);
            const float c = cosf(theta), s = sinf(theta);
            const bool major   = (i % 2 == 0);
            const int  tickLen = major ? 10 : 5;
            lv_point_t p1 = {(lv_coord_t)(px + (int)(c * arm)),
                             (lv_coord_t)(py - (int)(s * arm))};
            lv_point_t p2 = {(lv_coord_t)(px + (int)(c * (arm - tickLen))),
                             (lv_coord_t)(py - (int)(s * (arm - tickLen)))};
            lv_draw_line_dsc_t tick_dsc;
            lv_draw_line_dsc_init(&tick_dsc);
            tick_dsc.color = major ? lv_color_hex(color) : lv_color_hex(0x666666);
            tick_dsc.width = major ? 2 : 1;
            lv_draw_line(draw_ctx, &tick_dsc, &p1, &p2);
            if (major && i > 0) {
                char buf[8];
                snprintf(buf, sizeof(buf), "%d", (int)(f * m_maxPower));
                lv_draw_label_dsc_t ld;
                lv_draw_label_dsc_init(&ld);
                ld.color = lv_color_hex(color);
                ld.font  = &lv_font_montserrat_14;
                ld.align = LV_TEXT_ALIGN_CENTER;
                const int lr = arm - tickLen - 12;
                const int lx = px + (int)(c * lr);
                const int ly = py - (int)(s * lr);
                lv_area_t la = {(lv_coord_t)(lx-16),(lv_coord_t)(ly-8),
                                (lv_coord_t)(lx+16),(lv_coord_t)(ly+8)};
                lv_draw_label(draw_ctx, &ld, &la, buf, NULL);
            }
        }
    };
    drawTicks(fwdPx, fwdPy, PI_F, PI_F/2.0f, 0x22c55e);  // forward
    drawTicks(refPx, refPy, 0.0f, PI_F/2.0f, 0xef4444);  // reflected

    // ----- SWR iso-curves -----
    // Each curve traces the geometric intersection of the two needle lines as
    // power varies at a fixed SWR (constant reflection coefficient Γ²).
    // Intersection formula (both pivots share the same y = cy):
    //   t_f = base2 * sin(thR) / (arm * sin(thF − thR))
    //   crossing = fwd_pivot + t_f * arm * (cos thF, −sin thF)
    static const float    swrValues[] = {1.5f, 2.0f, 3.0f, 5.0f, 10.0f};
    static const uint32_t swrColors[] = {0x84cc16, 0xeab308, 0xf97316, 0xef4444, 0xa855f7};
    lv_draw_line_dsc_t curve_dsc;
    lv_draw_line_dsc_init(&curve_dsc);
    curve_dsc.width = 1;
    curve_dsc.opa   = LV_OPA_60;
    const float base2 = (float)(fwdPx - refPx);
    for (int si = 0; si < 5; si++) {
        const float swr = swrValues[si];
        const float g   = (swr - 1.0f) / (swr + 1.0f);
        const float g2  = g * g;
        curve_dsc.color = lv_color_hex(swrColors[si]);
        bool havePrev = false;
        int prevX = 0, prevY = 0;
        for (int k = 1; k <= 40; k++) {
            const float ff  = (float)k / 40.0f;
            const float rf  = fminf(g2 * ff, 1.0f);
            const float thF = PI_F - ff * (PI_F / 2.0f);
            const float thR = rf  * (PI_F / 2.0f);
            const float sinR = sinf(thR);
            const float sinD = sinf(thF - thR);
            if (fabsf(sinD) < 0.001f || fabsf(sinR) < 0.001f) { havePrev = false; continue; }
            const float tf = base2 * sinR / ((float)arm * sinD);
            if (tf < 0.0f || tf > 1.05f) { havePrev = false; continue; }
            const int ix = fwdPx + (int)(tf * (float)arm * cosf(thF));
            const int iy = fwdPy - (int)(tf * (float)arm * sinf(thF));
            if (havePrev) {
                lv_point_t p1 = {(lv_coord_t)prevX, (lv_coord_t)prevY};
                lv_point_t p2 = {(lv_coord_t)ix,    (lv_coord_t)iy};
                lv_draw_line(draw_ctx, &curve_dsc, &p1, &p2);
            }
            prevX = ix; prevY = iy; havePrev = true;
        }
    }

    // ----- Needles -----
    lv_draw_line_dsc_t needle_dsc;
    lv_draw_line_dsc_init(&needle_dsc);
    needle_dsc.width     = 3;
    needle_dsc.round_end = true;
    needle_dsc.color = lv_color_hex(0x00ff00);
    { lv_point_t p1={(lv_coord_t)fwdPx,(lv_coord_t)fwdPy},
                 p2={(lv_coord_t)fwdTx,(lv_coord_t)fwdTy};
      lv_draw_line(draw_ctx, &needle_dsc, &p1, &p2); }
    needle_dsc.color = lv_color_hex(0xff0000);
    { lv_point_t p1={(lv_coord_t)refPx,(lv_coord_t)refPy},
                 p2={(lv_coord_t)refTx,(lv_coord_t)refTy};
      lv_draw_line(draw_ctx, &needle_dsc, &p1, &p2); }

    // ----- Pivot dots -----
    lv_draw_rect_dsc_t rd;
    lv_draw_rect_dsc_init(&rd);
    rd.radius = LV_RADIUS_CIRCLE;
    rd.bg_color = lv_color_hex(0x00aa00);
    lv_area_t fa={(lv_coord_t)(fwdPx-5),(lv_coord_t)(fwdPy-5),
                  (lv_coord_t)(fwdPx+5),(lv_coord_t)(fwdPy+5)};
    lv_draw_rect(draw_ctx, &rd, &fa);
    rd.bg_color = lv_color_hex(0xaa0000);
    lv_area_t ra={(lv_coord_t)(refPx-5),(lv_coord_t)(refPy-5),
                  (lv_coord_t)(refPx+5),(lv_coord_t)(refPy+5)};
    lv_draw_rect(draw_ctx, &rd, &ra);

    // ----- SWR text -----
    char swrBuf[16];
    snprintf(swrBuf, sizeof(swrBuf), "%.1f:1", m_swr);
    lv_draw_label_dsc_t swr_dsc;
    lv_draw_label_dsc_init(&swr_dsc);
    swr_dsc.color = (m_swr > 2.0f) ? lv_color_hex(0xff4444) :
                    (m_swr > 1.5f) ? lv_color_hex(0xffaa00) : lv_color_hex(0x00ff00);
    swr_dsc.font  = &lv_font_montserrat_24;
    swr_dsc.align = LV_TEXT_ALIGN_CENTER;
    lv_area_t swr_a = {(lv_coord_t)(cx-30),(lv_coord_t)(cy-arm/2-12),
                       (lv_coord_t)(cx+30),(lv_coord_t)(cy-arm/2+12)};
    lv_draw_label(draw_ctx, &swr_dsc, &swr_a, swrBuf, NULL);
}

void DisplayUI::displayFlush(lv_disp_drv_t* disp, const lv_area_t* area, lv_color_t* color_p) {
    uint32_t w = area->x2 - area->x1 + 1;
    uint32_t h = area->y2 - area->y1 + 1;

    s_instance->m_tft->startWrite();
    s_instance->m_tft->setAddrWindow(area->x1, area->y1, w, h);
    s_instance->m_tft->pushColors((uint16_t*)&color_p->full, w * h, true);
    s_instance->m_tft->endWrite();

    lv_disp_flush_ready(disp);
}

void DisplayUI::btnMemTuneEvent(lv_event_t* e) {
    if (s_instance && s_instance->m_tuner) s_instance->m_tuner->memoryTune();
}

void DisplayUI::btnFullTuneEvent(lv_event_t* e) {
    if (s_instance && s_instance->m_tuner) s_instance->m_tuner->fullTune();
}

void DisplayUI::btnAnt1Event(lv_event_t* e) {
    if (s_instance && s_instance->m_tuner && s_instance->m_activeAnt != ANT_A)
        s_instance->m_tuner->toggleAntenna();
}

void DisplayUI::btnAnt2Event(lv_event_t* e) {
    if (s_instance && s_instance->m_tuner && s_instance->m_activeAnt != ANT_B)
        s_instance->m_tuner->toggleAntenna();
}

void DisplayUI::btnBypassEvent(lv_event_t* e) {
    if (s_instance && s_instance->m_tuner) s_instance->m_tuner->bypass();
}

void DisplayUI::btnAutoEvent(lv_event_t* e) {
    if (s_instance && s_instance->m_tuner) s_instance->m_tuner->setAutoMode();
}

void DisplayUI::meterTapEvent(lv_event_t* e) {
    if (!s_instance) return;
    s_instance->m_highScale = !s_instance->m_highScale;
    s_instance->m_maxPower = s_instance->m_highScale ? 1000.0f : 100.0f;
    lv_label_set_text(s_instance->m_scaleLabel, s_instance->m_highScale ? "1000W" : "100W");
    lv_obj_invalidate(s_instance->m_meter);
}

#endif // WITH_DISPLAY
