ben-kuhn/Remote-LDGControl/(commit log)

2026-06-02 Initial release: ESP32 remote controller for LDG AG-1000ProII/AG-600ProII
    - Tuner protocol layer (serial comm, commands, meter parsing)
    - Web interface with SSE for real-time meter updates
    - MQTT integration for telemetry and commands
    - LVGL cross-needle meter display with touchscreen
    - Remote unit link via HTTP/SSE (no MQTT broker required)
    - WiFiManager captive portal for network configuration
    - GitHub Actions CI/CD with web flasher via ESP Web Tools
    - Three build targets: display, remote, nodisplay
    [partitions_custom.csv]
2026-06-02 Clarify meter PSU voltage is the tuner's supply voltage, not ESP32's
2026-06-05 Move captive portal to HTTPS, add voltage sensor and UI refresh
    Replace the AsyncWebServer HTTP captive portal with esp32_idf5_https_server
    on port 443. Self-signed RSA cert/key are generated on first boot and
    persisted to NVS (portal_cert), so the private key isn't burned into
    firmware. The portal UI is a two-step scan + credentials flow.
    Add voltage_sensor for ADC-based PSU voltage auto-detect on GPIO 34 via
    the 100k/22k divider. Refresh the runtime web UI in data/index.html and
    update wiring docs.
    [config.h, config_manager.cpp, config_manager.h, display_ui.cpp, portal_cert.cpp, portal_cert.h, tuner_protocol.cpp]
2026-06-05 Fix captive portal hard timeout and AP-mode reconnect spam
    config_manager: drop the 5-min PORTAL_TIMEOUT that tore down HTTPSServer
    and DNSServer while softAP kept beaconing — users who took longer than
    5 minutes to configure ended up associated to a beaconing AP with a dead
    portal. Loop until WiFi.status() == WL_CONNECTED. Add a 30s heap log
    (portal: uptime=Ns heap_free=...) so memory pressure during long portal
    sessions is visible.
    main: the WiFi reconnect block ran every 10s in AP-only mode, calling
    WiFi.reconnect() with no STA configured and logging "WiFi disconnected,
    attempting reconnect..." constantly — masking real STA events. Gate the
    block on WiFi.getMode() being STA or AP_STA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
    [config_manager.cpp, main.cpp]
2026-06-05 Fix XSS in captive portal /scan rendering
    The portal page built the WiFi network list with HTML string
    concatenation and assigned it via innerHTML, treating WiFi SSIDs —
    which are sourced from the radio environment, not the user — as
    trusted HTML. The existing .replace(/'/g,"\\'") only escaped the
    JS-string passed to the onclick handler; it did nothing for the
    outer HTML context. A nearby attacker broadcasting an SSID like
    <img src=x onerror=...> could execute JavaScript in the portal's
    origin, then POST to the unauthenticated /save to silently change
    the device's target WiFi network (handing the attacker LAN-level
    control of the device during setup).
    Rebuild the list with createElement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
    [config_manager.cpp]
2026-06-06 Move runtime web server to HTTPS and use configured creds
    Two related fixes to the runtime web API.
    1) HTTPS on :443 instead of cleartext.
    web_server.cpp previously instantiated `new AsyncWebServer(443)` — but
    ESPAsyncWebServer has no TLS, so the server emitted HTTP on the HTTPS
    port, which both broke browsers (TLS handshake against a non-TLS
    server) and would have leaked Basic Auth credentials in cleartext if
    any client happened to speak HTTP-on-443. Replace with
    esp32_idf5_https_server (the same library the captive portal uses),
    reusing the device's self-signed cert via a new portalCert_newSSLCert()
    helper. All handlers move to plain HTTPSCallbackFunction signat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
    [config_manager.cpp, main.cpp, portal_cert.cpp, portal_cert.h, security.cpp, web_server.cpp, web_server.h]
2026-06-06 Persist STA creds and drop setup-mode code after configuration
    Three coordinated changes that match the project's "no setup code while
    in STA mode" intent and unstick the display-variant link.
    1) Persist WiFi STA credentials in NVS.
    arduino-esp32 3.x no longer auto-persists credentials passed to
    WiFi.begin() — and the captive-portal flow was relying on that
    behavior. As a result, every power-cycle re-entered the portal
    regardless of prior configuration. Add wifiSSID[33] and
    wifiPassword[65] fields to DeviceConfig, persist them via Preferences
    in the same "ldg-config" namespace, and read them back in
    ConfigManager::setupWiFi() (which previously read WiFi.SSID(), which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
    [config_manager.cpp, config_manager.h, display_ui.cpp, web_server.cpp]
2026-06-07 Update docs to match wiring diagram: LM7805 regulator, NS2009 I2C touch, separate 12V supply
    - WIRING.md: Complete rewrite to match wiring-diagram.svg
    - Power: separate 12V supply (not from tuner), LM7805 regulator
    - Touch: NS2009 I2C (SDA=21, SCL=22, IRQ=39) instead of XPT2046 SPI
    - Display: JST-XH 10-pin connector pinout
    - Mini-DIN pin 1: N/C (not +12V)
    - GPIO 34: voltage sense (not unused)
    - GPIO 33: not used for touch (was Touch CS)
    - Updated ESP32 pin diagram to match actual NodeMCU layout
    - README.md: Updated hardware sections
    - Regulator: LM7805 (was LM2940CT-5.0)
    - Touch: NS2009 I2C (was XPT2046 SPI)
    - Power: separate 12V supply (was from tuner +12V)
    - Wiring t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
2026-06-07 Embed wiring SVG in docs, replace ASCII art diagrams
    - WIRING.md: Embed wiring-diagram.svg at top, replace ASCII art with
    markdown tables and compact text descriptions
    - README.md: Embed wiring-diagram.svg in Hardware section
2026-06-07 Fix cross-needle meter geometry on both web and LVGL displays
    The web canvas and the LVGL display were both drawing the cross-needle
    meter with the wrong convention. Web had needles sweeping outward from
    "rest = vertical up" to "full = horizontal off-screen", so at full scale
    the needle tip was past the right/left edge of the meter face. LVGL had
    the pivots on the wrong sides (forward bottom-left, reflected bottom-
    right — opposite of the convention CLAUDE.md describes and the recent
    71264ea/1179de1 commits established for the web UI) and swept the needle
    through a 180° arc that crossed the entire face. The SWR curves were
    computed against these broken needle positions, so they ended up a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
    [display_ui.cpp]
2026-06-07 Fix wiring diagram: add missing SCK connection (Display P6 → GPIO 18)
    - GPIO 18 was mislabeled as '10' on left side of ESP32
    - Added wire from Display P6 (SCK) to GPIO 18
    - Updated legend text to include P6(SCK)→18
2026-06-07 Web flasher: write bootloader + partition table + app, not just app at 0
    The deploy-pages job built manifest-*.json files that listed only
    firmware.bin at offset 0. esp-web-tools obeyed that, erased the full
    4 MB flash, and then wrote the application image over the address
    where the bootloader belongs (0x1000) — leaving the chip unbootable
    and the user staring at "Erasing…" for the duration. (PlatformIO's
    firmware.bin is just the application; the bootloader and partition
    table are separate artefacts that have to land at fixed offsets.)
    Copy the bootloader, partition table, and boot_app0 OTA-selector
    alongside the application in the artifact, and emit manifests with
    all four parts at the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
2026-06-08 Fix captive portal "no ssid" error: parse the body the client actually sends
    The portal JS posted credentials with `new FormData()`, which fetch sends as
    multipart/form-data. The server-side handler in handleSave() parsed the body
    as application/x-www-form-urlencoded, so the `ssid` key was never found and
    every submission failed with {"error":"no ssid"} regardless of which network
    was selected. This regressed when the portal moved from AsyncWebServer to
    esp32_idf5_https_server: the AsyncWebServer side parsed multipart natively;
    the hand-rolled urlencoded parser written for the HTTPS port did not.
    Two changes:
    - Client: switch the submission from FormData to URLSearchParams so it
    actually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
    [config_manager.cpp]
2026-06-08 CLAUDE.md: note that /dev/ttyUSB1 runs the esp32-remote variant and should be kept flashed with the current build
2026-06-08 Add display troubleshooting notes for BTT TFT35-SPI V2.1 gray-screen issue
    Captures what was learned from the BTT schematic — the V2.1 is a passive
    ILI9488 + NS2009 breakout (no onboard MCU), and J1 does not bring out RST
    or BL (both handled on-board). Documents the proposed fix (drop phantom
    TFT_RST/TFT_BL pins, lower SPI_FREQUENCY to 20 MHz, add a red-fill probe,
    fix the README pin table) so the debug can be resumed on a different
    machine without losing context.
2026-06-08 Add OpenSCAD enclosure designs for display and nodisplay/remote variants
    common.scad holds shared geometry; display_case.scad and nodisplay_case.scad
    are the per-variant cases.
    [common.scad, display_case.scad, nodisplay_case.scad]
2026-06-08 Fix captive portal "no ssid": read full request body across SSL records
    The handlers in ConfigManager::handleSave and WebServer's readRequestBody
    both drove the body-read loop off `req->readBytes() > 0`. That's wrong:
    esp32_idf5_https_server's readBytes() is non-blocking and returns 0
    whenever the decrypted receive buffer is momentarily empty — NOT only at
    end-of-body. Real clients (phone over the AP, HTTPS) reliably split the
    form body across multiple SSL records, so the loop bailed out after the
    first chunk and the parser saw a truncated body without `ssid=`. The
    previous fix (URLSearchParams + percent-decode) was correct on its own
    terms but couldn't take effect because the body it pars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
    [config_manager.cpp, web_server.cpp]
2026-06-08 CLAUDE.md: document NixOS pio invocation and pre-flash port hygiene
    Two things future-me kept getting wrong:
    1. On this NixOS host, the .venv/pip-installed pio can't build — the
    prebuilt xtensa toolchain expects a standard ld-linux that's a
    stub-ld here. Wrapping every command in `nix-shell -p platformio`
    is the working pattern (the nixpkgs platformio is FHS-wrapped).
    Spell it out and steer away from steam-run / nix-ld / patchelf
    detours that aren't set up on this machine.
    2. esptool's 921600-baud upload fails with "Invalid head of packet"
    if anything else is reading /dev/ttyUSB1 — bit by this when a
    background `cat /dev/ttyUSB1 >> log` watch was running during a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
2026-06-09 Display: init before WiFi, cross-needle meter, dual ANT buttons with names
    - Move display.begin() and tuner.begin() before setupWiFi() so the meter
    is live during captive portal and for offline use; add portal idle callback
    so LVGL and the tuner keep running while waiting for WiFi config
    - Make lv_disp_draw_buf_t and lv_disp_drv_t static in begin() to prevent
    dangling pointer crashes (LVGL 8 stores raw pointers, not copies)
    - Remove PSRAM build flags (NodeMCU ESP32S v1.1 has no PSRAM)
    - Fix TFT pin config for BTT TFT35-SPI V2.1: RST=-1, no BL pin, SPI 20MHz
    - Rewrite cross-needle meter geometry: each needle arc centered at its own
    pivot with correct 90° sweep; SWR iso-curves via int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
    [User_Setup.h, config_manager.cpp, config_manager.h, display_ui.cpp, display_ui.h, main.cpp, web_server.cpp]
2026-06-09 Add network consolidation plan and display IP fix
    - Write 9-task implementation plan for network consolidation
    - Add updateNetworkInfo() to DisplayUI to refresh SSID/IP labels after WiFi connects
    - Log error when web server fails to start (port 443 conflict)
    [display_ui.cpp, display_ui.h, main.cpp]
2026-06-09 build: remove nodisplay env, drop REMOTE_UNIT flag from esp32-remote
2026-06-09 build: update CI and docs for two-build consolidation (remove nodisplay references)
    The esp32-nodisplay environment has been consolidated into esp32-remote, which
    now serves as the single headless build with full web server and tuner UART
    support. Updated CI pipeline to build only esp32-display and esp32-remote,
    removed nodisplay from release manifests, and updated build matrix documentation.
2026-06-09 config: add static IP and remoteHost fields to DeviceConfig
    Add static IP configuration fields (useStaticIP, staticIP, staticNetmask,
    staticGateway, staticDNS) and remoteHost field to DeviceConfig struct.
    Update loadDefaults(), save(), and load() to handle these new fields
    with appropriate defaults and NVS persistence.
2026-06-09 ui: add static IP configuration and remote host to settings
    Replace read-only SSID/IP network section with editable static IP form
    (IP, netmask, gateway, DNS), DHCP current-values display, and a
    Remote Unit Host field shown only on display builds.
2026-06-09 ui: replace toggle button with named active/inactive antenna buttons
    Removes the "Toggle Ant" button and "Antenna: --" status row; replaces
    with side-by-side ANT 1 / ANT 2 buttons that highlight the active
    antenna (green) and dim the inactive one, clicking the inactive sends
    the toggle command. Button labels update from ant1Name/ant2Name config.
2026-06-09 cleanup: remove stale REMOTE_UNIT ifdefs from mqtt_handler and config.h, fix arc comment
    Removed dead #ifdef REMOTE_UNIT conditional code from mqtt_handler.cpp since the build flag
    was removed and all builds now behave like the display/nodisplay variant. Replaced REMOTE_UNIT_ID
    references with hardcoded 0 (non-remote unit ID). Removed the REMOTE_UNIT_ID definition block
    from config.h. Also fixed misleading arc comment in index.html drawMeter() function.
    [config.h, mqtt_handler.cpp]
2026-06-09 cleanup: replace REMOTE_UNIT_ID with hardcoded 0 in config_manager.cpp
    [config_manager.cpp]
2026-06-10 Captive portal: reboot after STA join instead of tearing the server down
    esp32_idf5_https_server's HTTPServer::setupSocket() binds without
    SO_REUSEADDR. The old setupWiFi() path stopped the portal HTTPSServer
    on :443 and then expected the runtime web server to bind the same
    port a moment later — but lwIP holds the previously-listening socket
    in TIME_WAIT, so the runtime's bind() returned EADDRINUSE with
    "setupSockets failed". On first-boot setup the device would join WiFi,
    report Connected: <ip>, then fail to serve anything on the runtime
    URL.
    Reboot instead. On next boot, setupWiFi()'s fast-path joins STA
    without ever starting the portal server, so :443 is free and the
    runtime web server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
    [config_manager.cpp]
2026-06-10 MQTT: honor configured broker, disable when broker is empty
    MqttHandler::begin() was passing the compile-time MQTT_BROKER/PORT/
    USERNAME/PASSWORD macros to PubSubClient, completely ignoring whatever
    the user had set in DeviceConfig. Combined with loadDefaults() seeding
    mqttBroker with the placeholder "192.168.1.100", every never-MQTT-
    configured device endlessly retried TCP connect to a fake host on a
    foreign subnet — visible as a ~5 s WiFiClient connect-timeout spam in
    the serial log for the entire uptime.
    Three changes:
    - mqtt_handler.cpp now reads broker/port/username/password from
    configManager.get() in begin() and connect().
    - main.cpp gates mqtt.begin() on cfg.mqttBroker[0] != '\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
    [config_manager.cpp, main.cpp, mqtt_handler.cpp]
2026-06-10 web_server SSE: detect dead-conn writes by length-match, not == 0
    The /api/events SSE handler's exit loop tracked failed writes with a
    sentinel — `size_t written = 1;` reset every iteration, then optionally
    updated to the *latest* res->print() return value. The check
    `written == 0` was meant to count consecutive write failures and bail
    after 5 — but the sentinel reset failedWrites to 0 on every iteration
    that didn't write anything (no new meter, no new status, keepalive not
    yet due), so failedWrites could never accumulate to 5 in practice.
    Worse, esp_tls_conn_write returns a negative ssize_t on connection
    reset / send failure; HTTPSConnection::writeBuffer just returns that
    as size_t, so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
    [web_server.cpp]
2026-06-10 ui: per-pivot meter arcs, fixed-length needles (mirror display_ui)
    The web UI's cross-needle meter drew one half-circle scale centered
    at the bottom-midline and split it into a green left half and a red
    right half. Needles pivoted at the bottom corners but their tips
    landed on that shared arc, so their length shrank from arm-distance
    at zero to ~arm/√2 at full scale — the needles visibly contracted
    as power rose, and full scale ended at "about half needle travel."
    Previous commit ea08724 only recolored the shared arc; the geometry
    was never rebased.
    Match src/display_ui.cpp: each pivot has its own arc with radius =
    needle length (arm), sweeping its upper quadrant. Forward arc sits
    in th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
2026-06-10 flash.html: add factory-reset toggle, drop obsolete nodisplay variant
    Adds a "Factory reset before flashing" checkbox at the top of the
    flasher page. When armed (red outline), JS mirrors the esp-web-tools
    `erase-first` attribute onto every install button, so the next click
    runs a full chip erase before writing — wiping NVS, LittleFS, app,
    and the portal TLS cert. Useful when a device is stuck or you want
    a known-clean state for first-boot setup again.
    Also drops the Basic Unit variant. After the network-consolidation
    commits the source builds only two envs (esp32-display and
    esp32-remote), and CI's build.yml only generates manifest-display
    and manifest-remote — the Basic Unit button poi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
2026-06-10 CLAUDE.md: note that 'pio upload' does NOT touch the LittleFS partition
    Bit by this today: web UI bug fixes in data/index.html appeared not
    to take effect after a `pio run -t upload`, because that flashes only
    the firmware (bootloader+partitions+app) — the LittleFS partition
    that serves data/ requires a separate `pio run -t uploadfs`. Easy to
    miss and easy to misdiagnose as "the build didn't take."
    Spell it out so future-me reaches for uploadfs whenever data/ has
    changed, and doesn't claim the device is on latest before checking.
2026-06-10 web_server SSE: harden h_events teardown path
    Three handler-side issues remained after the length-match fix in
    0ac563c, all of which leak a worker slot when the client goes away:
    1. Response header was `Connection: keep-alive`. The library checks
    the *response* Connection header after the handler returns: if it
    sees keep-alive AND the response was buffered, it transitions back
    to STATE_INITIAL and keeps the SSL session open expecting the next
    request — which for a stream that just disconnected means the slot
    sits idle until the keep-alive timeout. Set "close" so the lib
    takes the simple STATE_BODY_FINISHED → closeConnection() path that
    tears down _ssl immediately.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
    [web_server.cpp]
2026-06-10 tests: deterministic reproduction for the SSE multi-close wedge
    Captures the trigger we worked out today: with 2+ SSE subscribers
    holding /api/events, dropping them all in quick succession puts the
    runtime web server into a state where the esp32_idf5_https_server
    library polls torn-down _ssl pointers, spamming
    `esp_tls_get_bytes_avail()` empty-arg errors at ~150/sec and
    starving the rest of the server. The runtime then stops answering
    on :443 even though the device is up on the LAN.
    The script spawns N curl SSE subscribers, lets them subscribe,
    SIGTERMs them all together, waits for the serial log to settle, and
    reports:
    - count of empty-arg storm lines since a unique anchor it wrote at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
2026-06-10 fix: NULL-guard esp_tls_* calls in HTTPSConnection (patch upstream lib)
    Closes the runtime web-server wedge that takes down :443 whenever
    2+ SSE subscribers (/api/events) close in quick succession. The
    trigger and deterministic reproduction are in tests/wedge_repro.sh.
    Root cause is in esp32_idf5_https_server's HTTPSConnection.cpp:
    closeConnection() frees `_ssl` and sets it to NULL but there are
    code paths in HTTPServer::loop / HTTPConnection::loop where the
    following accessors still get called on a slot whose `_ssl` is
    NULL and whose connection object hasn't been deleted yet:
    - HTTPSConnection::writeBuffer → esp_tls_conn_write(NULL,...)
    - HTTPSConnection::readBytesToBuffer →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
    [apply_patches.py]
2026-06-10 scripts: add DTR/RTS-safe serial monitor, note the gotcha in CLAUDE.md
    Opening /dev/ttyUSB1 with default Linux/pyserial flags asserts DTR
    and RTS. On the NodeMCU-style board we use, those are wired to the
    ESP32's GPIO0 (boot select) and EN (reset) respectively, with DTR
    asserted = GPIO0 low (download mode) and RTS asserted = EN low
    (reset held). A `cat /dev/ttyUSB1 >> log` background watcher therefore
    holds the chip in reset+download for as long as it's running, which
    looks identical to "the chip is bricked" — no boot output despite a
    fresh flash, USB enumerated, RTS pulses doing nothing.
    Spent hours today chasing the wrong diagnosis (NVS corruption, flash
    content) before figuring out it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
    [serial_monitor.py]
2026-06-30 web_server: replace SSE with WebSocket for meter telemetry
    SSE blocked command POSTs while a subscriber held the slot; WebSocket
    handlers dispatch non-inline so browsers get a persistent meter feed
    without starving the command endpoints.
    - Move webServer.loop() to dedicated FreeRTOS task so streaming can't
    freeze loop()'s tuner.process()
    - Add recursive mutex to TunerProtocol for UART access shared between
    the main task and webServer task
    - Switch portal cert from RSA-2048 to ECDSA P-256 (HW-accelerated,
    ~10x faster handshakes); versioned so existing installs auto-regen
    - Bump HTTPS_CONNECTION_DATA_CHUNK_SIZE to 2048 for WS upgrade headers
    - Add bearer-token auth middleware for WS upg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
    [main.cpp, portal_cert.cpp, tuner_protocol.cpp, tuner_protocol.h, web_server.cpp, web_server.h]
2026-06-30 cases: rewrite both enclosures from scratch
    Remote case: simple project box with ESP32 + breakout standoffs,
    PowerPole pocket and cable notch at top rear, strain relief clamp
    on lid.
    Display case: trapezoid profile with ESP32 on floor, tilted panel
    as removable lid with TFT cutout, PowerPole and cable exit at
    floor level on back wall with strain relief clamp.
    [common.scad, display_case.scad, nodisplay_case.scad]
2026-06-30 cases: redesign nodisplay case with nut traps, side-wall powerpole pocket, larger box
    [nodisplay_case.scad]
2026-06-30 cases: fix floor nut traps — blind hex pockets with screw clearance holes, 4mm floor
    [nodisplay_case.scad]
2026-06-30 cases: move nut traps to bottom of floor, screw passes from top
    [nodisplay_case.scad]
2026-06-30 cases: remove corner posts, move lid nut traps to floor underside
    [nodisplay_case.scad]
2026-06-30 cases: move powerpole pocket to back wall with retention pin
    [nodisplay_case.scad]
2026-06-30 cases: move powerpole pocket to side wall with pin at locking hole position
    [nodisplay_case.scad]
2026-06-30 cases: fix powerpole pocket to cut through wall
    [nodisplay_case.scad]
2026-06-30 cases: powerpole pocket flat against side wall, hole through back wall, pin retention
    [nodisplay_case.scad]
2026-06-30 cases: fix powerpole pocket - 10mm deep recess, hole through back wall
    [nodisplay_case.scad]
2026-06-30 cases: add boss for powerpole pocket to create solid material
    [nodisplay_case.scad]
2026-06-30 cases: move PowerPole to floor pocket, relocate screw to secure connector
    [nodisplay_case.scad]
2026-06-30 cases: fix PowerPole floor pocket depth - 2mm recess instead of through-floor
    [nodisplay_case.scad]
2026-07-01 cases: add PowerPole enclosure with walls and ceiling, connector sits flush on floor
    [nodisplay_case.scad]
2026-07-01 cases: fix strain relief clamp - position inside box, add nut pockets to lid, fix groove geometry
    [nodisplay_case.scad]
2026-07-01 cases: align strain relief clamp with cable notch, increase thickness, ensure screw holes
    [nodisplay_case.scad]
2026-07-01 cases: redesign strain relief clamp as arch strap over cable
    [nodisplay_case.scad]
2026-07-01 cases: redesign strain relief clamp as arched strap with feet
    [nodisplay_case.scad]
2026-07-01 cases: make strain relief clamp arch thin (3mm) like the feet
    [nodisplay_case.scad]
2026-07-02 cases: fix strain relief clamp - orient feet along cable, reduce arch height to grip 5-6mm cable
    [nodisplay_case.scad]
2026-07-08 cases: fix ESP32 breakout board dimensions to 71.5mm x 57.5mm
    [common.scad]
2026-07-08 cases: correct ESP32 breakout board dimensions - hole spacing is 71.5mm x 57.5mm
    [common.scad]
2026-07-08 cases: center ESP32 in box to move mounting holes away from edges
    [nodisplay_case.scad]
2026-07-08 cases: fix strain relief clamp screw holes - make them tall enough to cut through arch material
    [nodisplay_case.scad]
2026-07-08 cases: fix strain relief clamp orientation and add flat screw head surfaces
    [nodisplay_case.scad]
2026-07-08 cases: align strain relief clamp arch with cable notch at front wall
    [nodisplay_case.scad]
2026-07-08 Revert "cases: align strain relief clamp arch with cable notch at front wall"
    This reverts commit 6c83a9dbd528e82fe4825e2a0e5c372f33664bd4.
    [nodisplay_case.scad]
2026-07-08 cases: move cable notch to align with strain relief clamp arch
    [nodisplay_case.scad]
2026-07-08 Revert "cases: move cable notch to align with strain relief clamp arch"
    This reverts commit 0a62ebbdb8d1c5166c8fe65ad0a32302b829627b.
    [nodisplay_case.scad]
2026-07-08 cases: extend cable notch down to align with strain relief arch
    [nodisplay_case.scad]
2026-07-08 cases: move cable notch and clamp to left side, away from powerpole
    [nodisplay_case.scad]
2026-07-08 Revert "cases: move cable notch and clamp to left side, away from powerpole"
    This reverts commit f868d7519a12f875c2dccd58d604091aa2fa95eb.
    [nodisplay_case.scad]
2026-07-08 cases: center cable notch on X axis
    [nodisplay_case.scad]
2026-07-08 cases: reduce strain relief clamp arch thickness to 2mm
    [nodisplay_case.scad]
2026-07-13 cases: fix remote PP pocket — open back for wire routing, add 2mm retention lip, offset for breakout clearance
    [nodisplay_case.scad]
2026-07-13 cases: widen remote box 6mm, shift ESP32 left for PP clearance
    [nodisplay_case.scad]
2026-07-13 cases: shrink remote box to 95x90x30mm, sized around 64x78mm board + PP pair
    [nodisplay_case.scad]
2026-07-13 cases: rotate breakout board 90° to fix nut trap placement, resize to 80x95mm
    [nodisplay_case.scad]
2026-07-13 cases: rotate PP 90° (mating face on right wall), shrink to 80x85x30mm, add standoffs for Z clearance
    [nodisplay_case.scad]
2026-07-20 cases: remove back-right standoff (inside PP pocket), add wire exit slot in back wall
    [nodisplay_case.scad]
2026-07-20 cases: remove plastic standoffs, shift board forward to clear PP pocket, fix wire exit
    [nodisplay_case.scad]
2026-07-20 cases: add 4th standoff, fix PP wire passage through pocket wall to interior
    [nodisplay_case.scad]
2026-07-20 cases: align lid screws with board standoffs, increase depth to 105mm for clearance
    [nodisplay_case.scad]
2026-11-12 cases: align nodisplay screw stacks and add PowerPole roll-pin hole
2026-11-12 cases: add nodisplay prototype STLs
2026-11-12 build: pin espressif32 platform to 7.0.1
2026-11-12 cases: rework display case onto remote footprint
2026-11-12 cases: single-cavity landscape display case
2026-11-12 cases: shorten single-cavity display case
2026-11-12 cases: add display screw access and floor cable clamp
2026-11-12 cases: front-mount display and fix nut pockets
2026-11-13 cases: flat floor with captured nuts and floor clamp
2026-11-13 cases: side-load lid nut pockets
